CSU-Agricultural-Water-Quality-Program/awqp-loggers/figures/Cercospora-PT-joint-fig.jpg

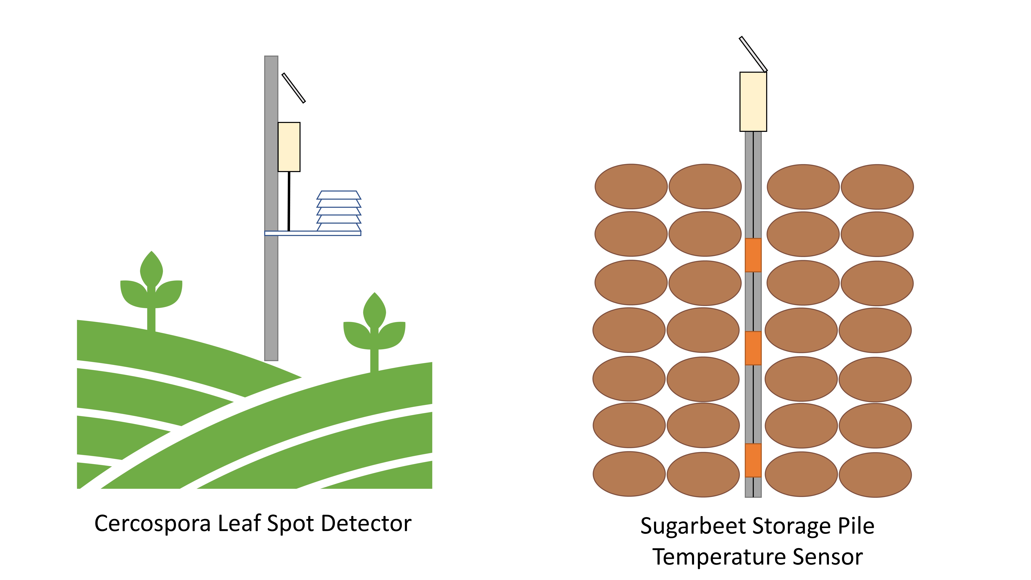
figures/Cercospora-PT-joint-fig.jpg
