CSU-Agricultural-Water-Quality-Program/awqp-loggers/figures/fig2.JPG

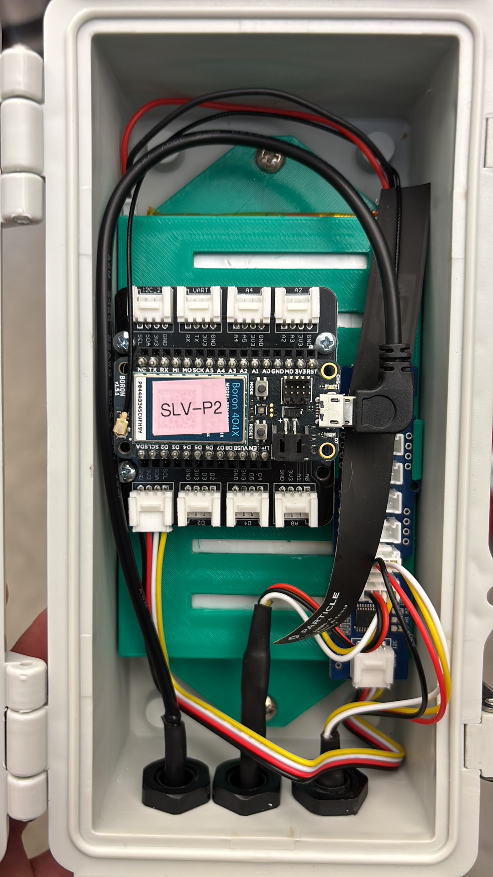
figures/fig2.JPG
