CSU-Agricultural-Water-Quality-Program/awqp-loggers/figures/Picture4.png

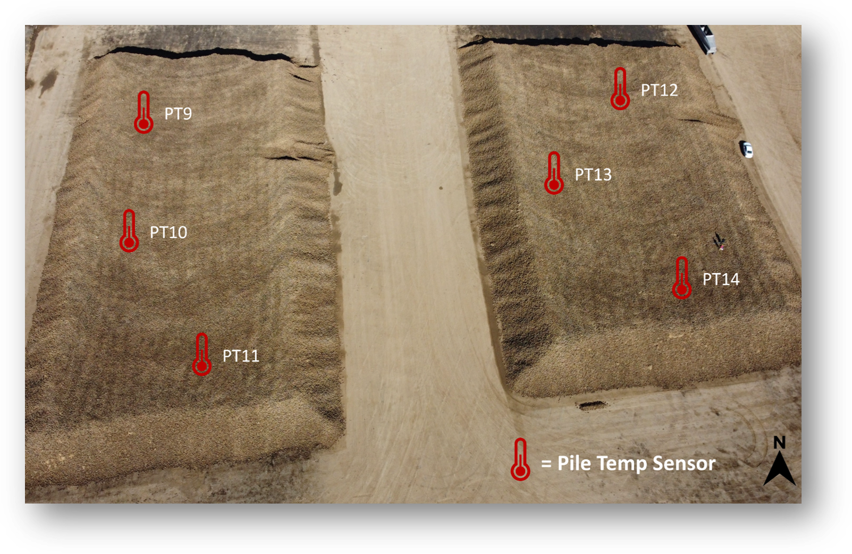
figures/Picture4.png
