CSU-Agricultural-Water-Quality-Program/awqp-loggers/instructional documents/2024 Cercospora Bill of Materials Powerpoint_9Feb2024.pdf

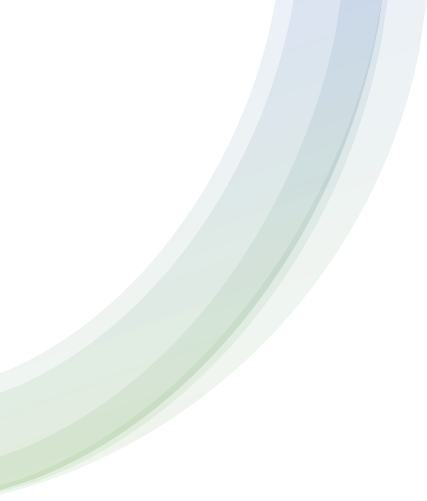
[picture p9: figure]
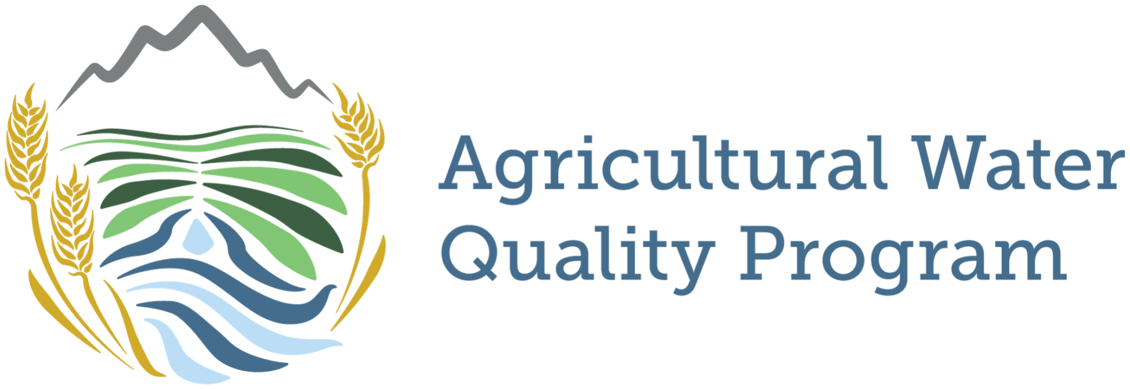
[picture p10: figure]
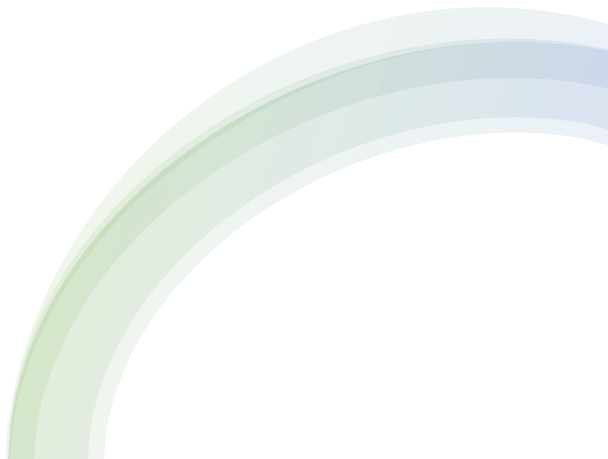
[picture p11: figure]

# Cercospora Bill of Materials

Created by the CSU Agricultural Water Quality Program

# Sensor Parts

SHT 31 Sensor Probe | Link: https://www.amazon.com/gp/p roduct/B09NYDCKF2/ref=ppx_y o_dt_b_search_asin_title?ie=U

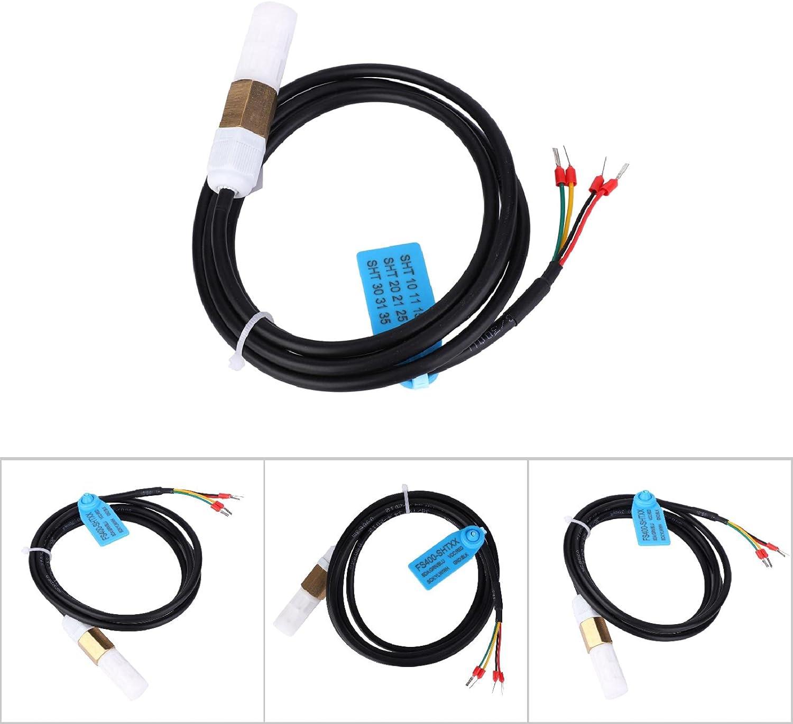
[picture p12: figure]

TF8&th=1 (https://www.amazon.com/gp/product/B09NYDCKF2/ref=ppx_yo_dt_b_search_asin_title?ie=UTF8&th=1)

Alternate if out of stock: Sht35: https://a.co/d/0hgxgrg

# Waterproof Polarized 4-Wire Cable Set

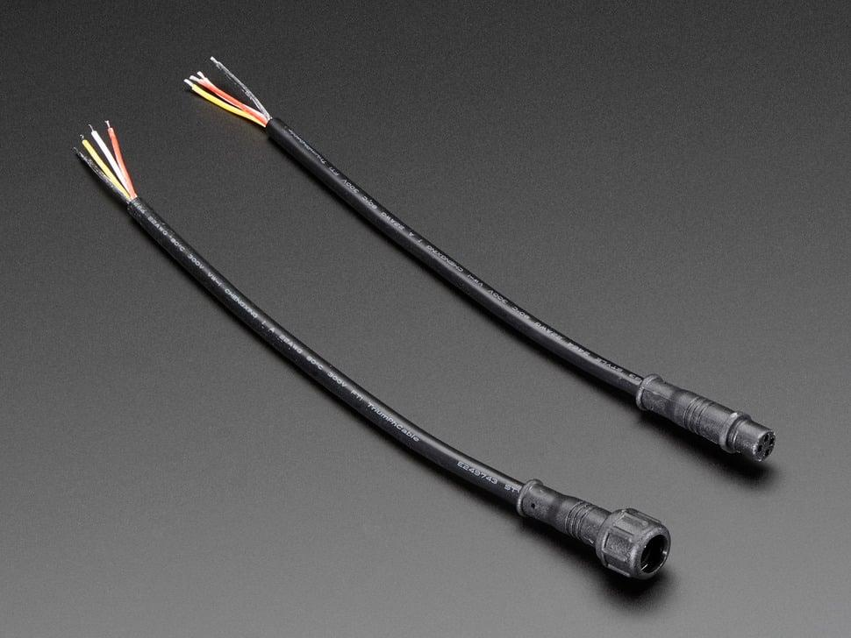
[picture p13: figure]

https://www.adafruit.com/product/744 (https://www.adafruit.com/product/744)

# Adafruit Micro Lipo - USB LiIon/LiPoly Charger

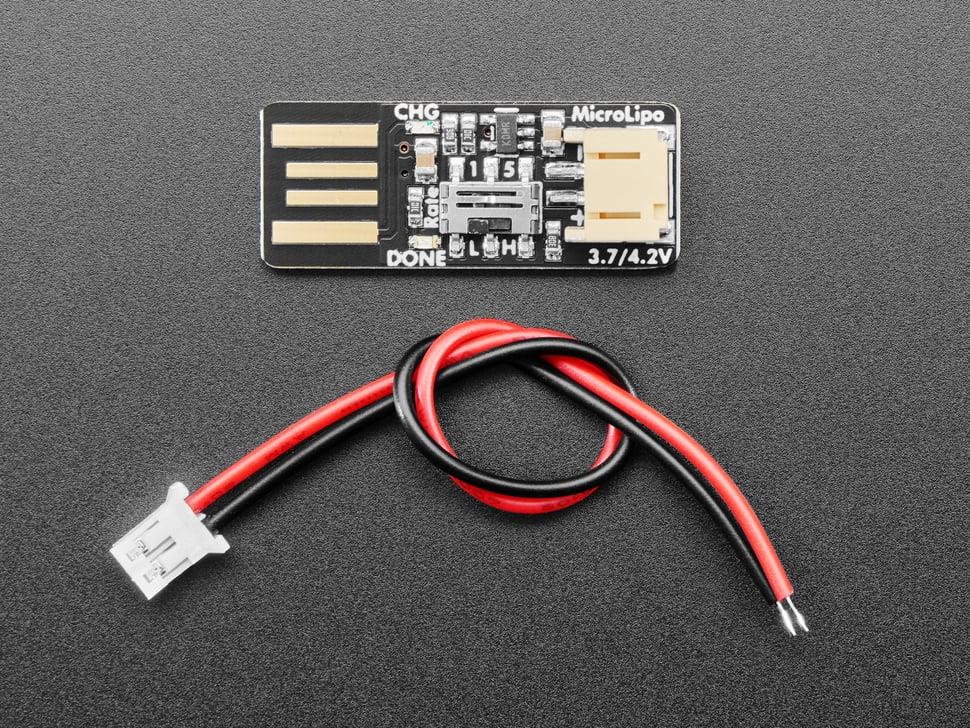
[picture p14: figure]

https://www.adafruit.com/product/1304 (https://www.adafruit.com/product/1304)

# Lithium Ion Battery Pack - 3.7V 4400mAh

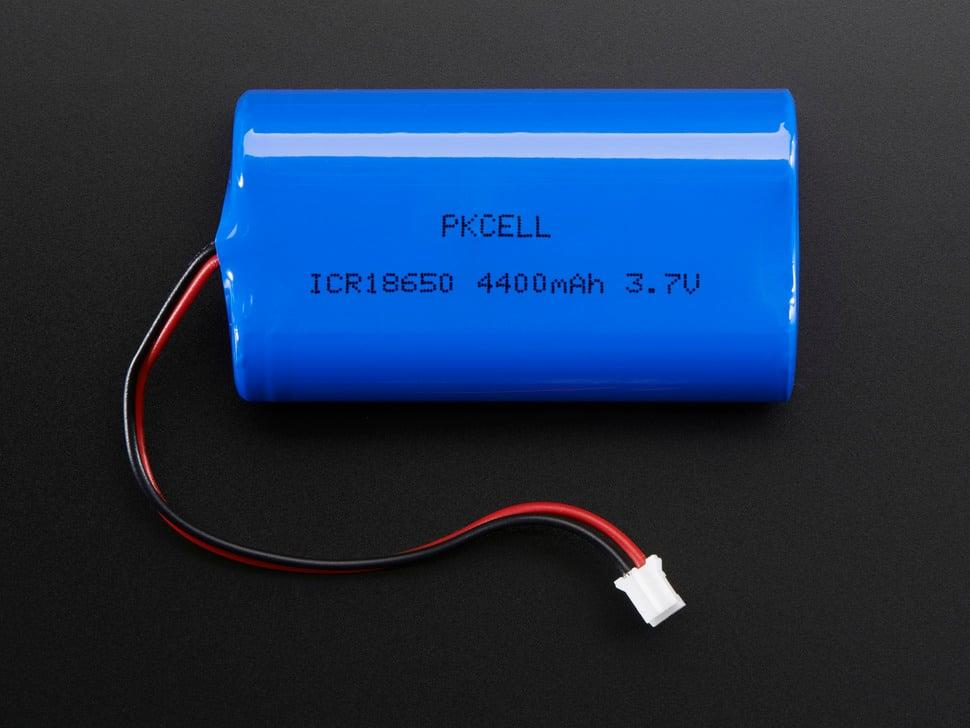
[picture p15: figure]

https://www.adafruit.com/product/354 (https://www.adafruit.com/product/354)

Alternate if out of stock: https://www.amazon.com/Battery-Packs-Lithium-Pack-3-
7V/dp/B0137IRGHG/ref=sr_1_1?crid =T7V5SLARPWZ3&keywords=Lithiu m+Ion+Battery+Pack+-
+3.7V+4400mAh&qid=1706741942 &sprefix=lithium+ion+battery+pack+ -
+3.7v+4400mah%2Caps%2C131&sr= 8-1 (https://www.amazon.com/Battery-Packs-Lithium-Pack-3-7V/dp/B0137IRGHG)

# Grove Shield FeatherWing

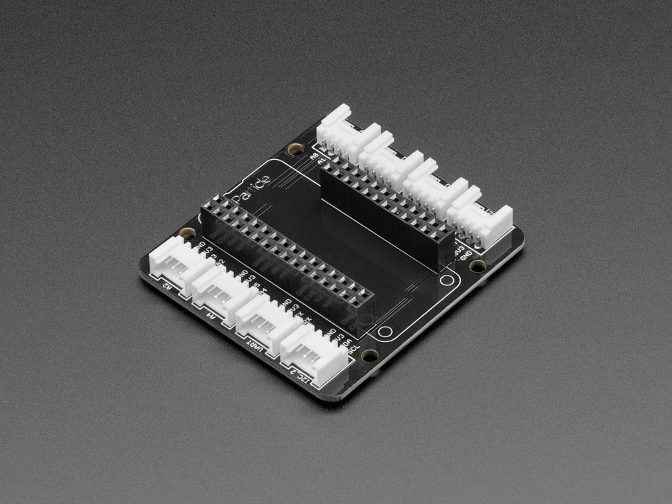
[picture p16: figure]

https://www.adafruit.com/product/4309 (https://www.adafruit.com/product/4309)

# Boron LTE CAT-M1 for North America (BRN404X)

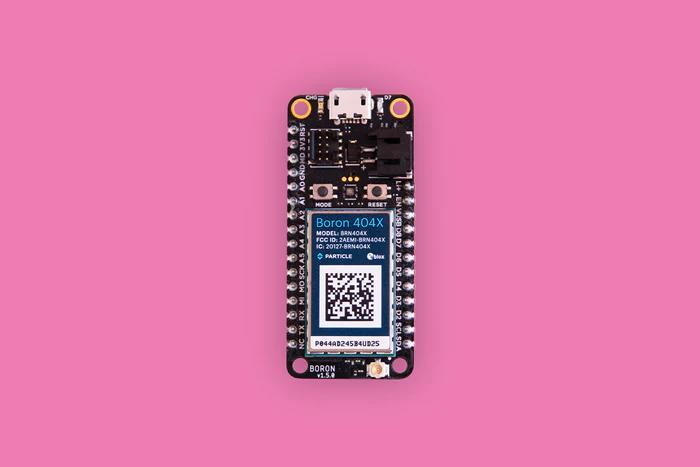
[picture p17: figure]

https://store.particle.io/collections/cellular/products/boron-lte-cat-m1-noram-with-ethersim-4th-gen

# Waterproof Enclosure (NEW)

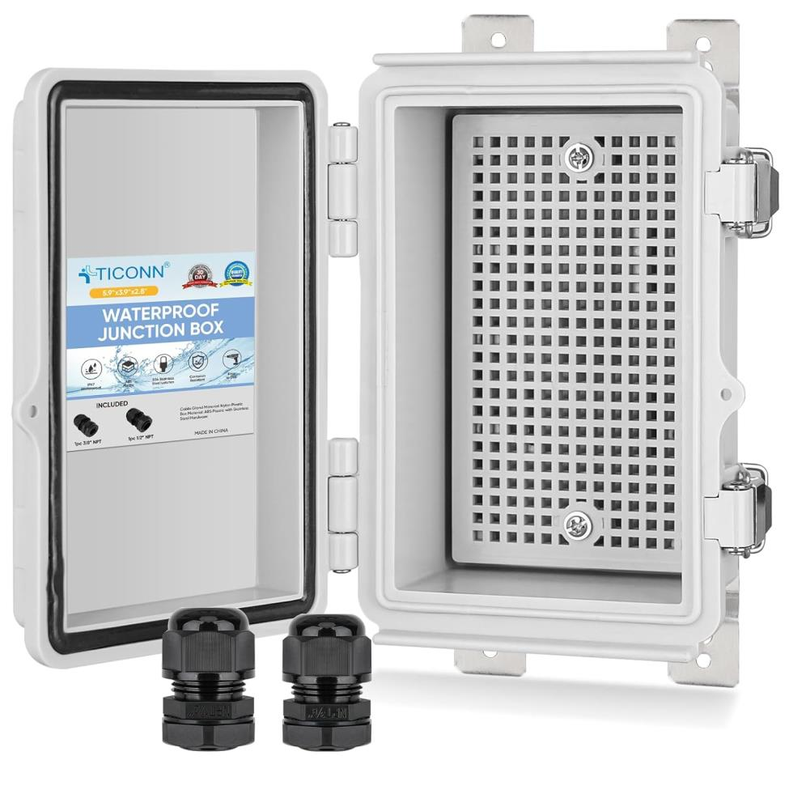
[picture p18: figure]

https://www.amazon.com/
dp/B0BZR3GZ4V/ref=twiste
r_B0B87THLGC?_encoding=
UTF8&psc=1 (https://www.amazon.com/dp/B0BZR3GZ4V/ref=twister_B0B87THLGC?_encoding=UTF8&psc=1)

# #6 x ½” Sheet Metal Screws

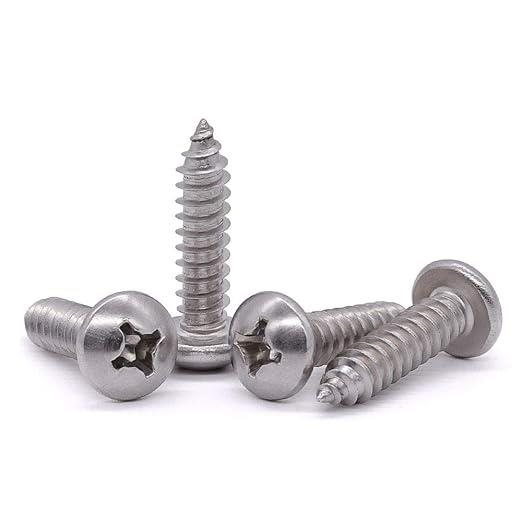
[picture p19: figure]

https://www.amazon.com/Stainless-Phillips-Tapping-Bright-Finish/dp/B08LV1M9FC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 (https://www.amazon.com/Stainless-Phillips-Tapping-Bright-Finish/dp/B08LV1M9FC)

# Silica Pack (30 pack)

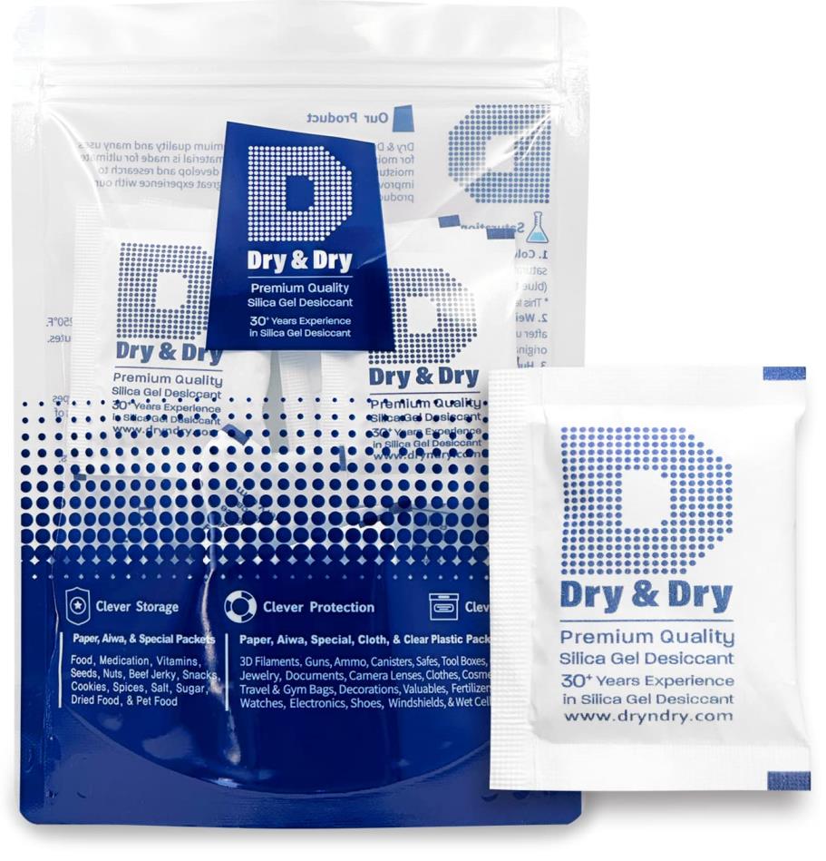
[picture p20: figure]

https://www.amazon.com/Dry-Premium-Packets-Desiccants-Dehumidifier/dp/B00VJ02VMK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 (https://www.amazon.com/Dry-Premium-Packets-Desiccants-Dehumidifier/dp/B00VJ02VMK)

# White Solder Seal Wire Connectors AWG26-24

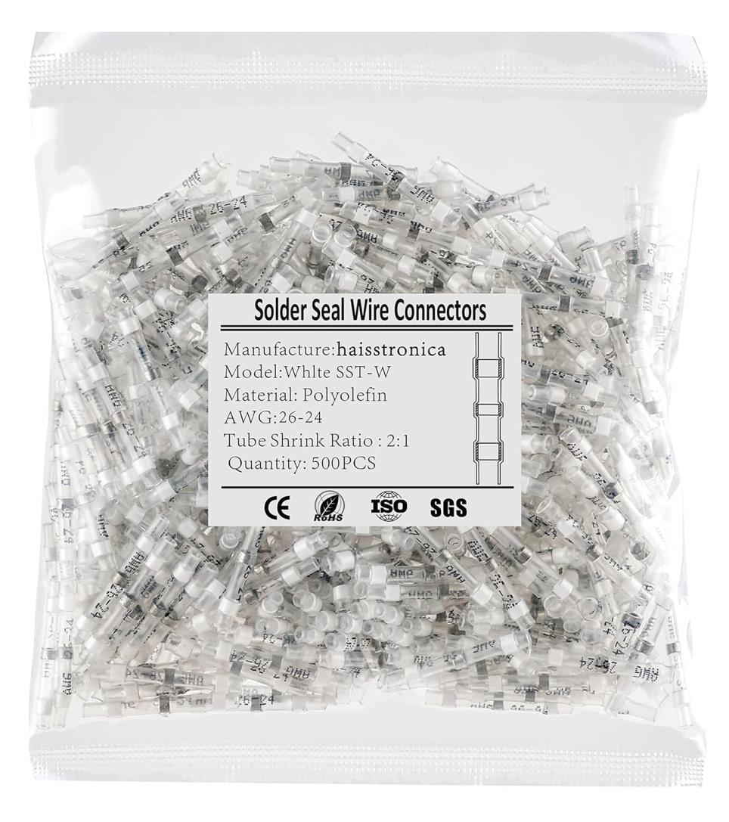
[picture p21: figure]

https://www.amazon.com/
gp/product/B09BHW6BWC
/ref=ppx_yo_dt_b_search_
asin_title?ie=UTF8&psc=1 (https://www.amazon.com/gp/product/B09BHW6BWC/ref=ppx_yo_dt_b_search_asin_title?ie=UTF8&psc=1)

# 1/4" Heat Shrink Tubing (50ft)

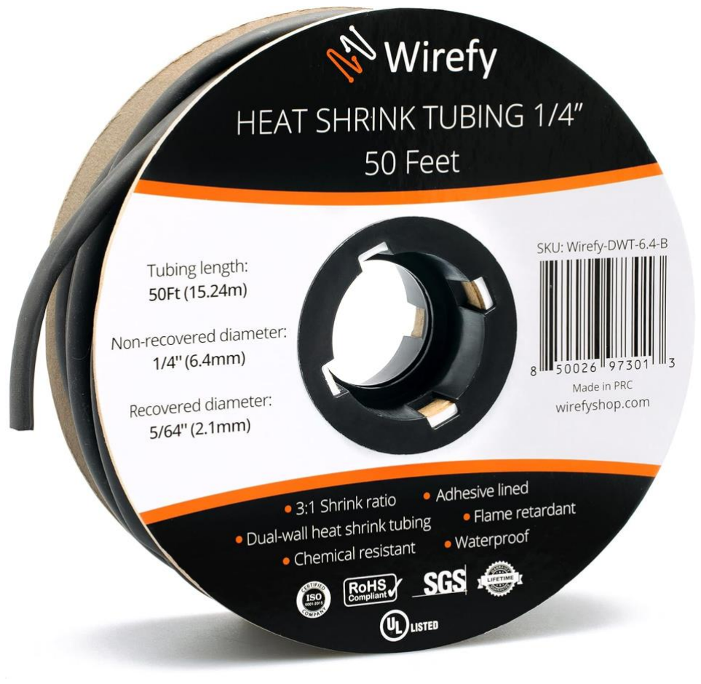
[picture p22: figure]

3:1 Ratio - Adhesive Lined - Marine Grade Heat Shrink - Black - 50 Feet Roll https://www.amazon.com/gp/product/B08W7RB32Z/ref=ppx_yo_dt_b_search_asin_title?ie=UTF8&th=1 (https://www.amazon.com/gp/product/B08W7RB32Z/ref=ppx_yo_dt_b_search_asin_title?ie=UTF8&th=1)

# Cable Gland (20 Pack) PG7 Waterproof

https://www.amazon.com/AMPELE-Waterproof-Plastic-Adjustable-3-5-
6mm/dp/B08TCFM4C7/ref=sxts_b2b_sx_reorder_ac b_customer?content-id=amzn1.sym.44ecadb3-1930-4ae5-8e7f-c0670e7d86ce%3Aamzn1.sym.44ecadb3-1930-4ae5-8e7fc0670e7d86ce&crid=1OH62VJ42NK1U&cv_ct_cx=pg 7%2Bcable%2Bgland&keywords=pg7%2Bcable%2Bgl and&pd_rd_i=B09X4GK3FT&pd_rd_r=d5becbf4-0c5a-42a5-abc4-
9cc85186de9b&pd_rd_w=O3qY1&pd_rd_wg=9baEq &pf_rd_p=44ecadb3-1930-4ae5-8e7fc0670e7d86ce&pf_rd_r=2YZKZZNZ8KDT9W166GAZ &qid=1702330671&sbo=RZvfv%2F%2FHxDF%2BO50 21pAnSA%3D%3D&sprefix=PG7%2B%2Caps%2C132 &sr=1-1-62d64017-76a9-4f2a-8002-d7ec97456eea&th=1

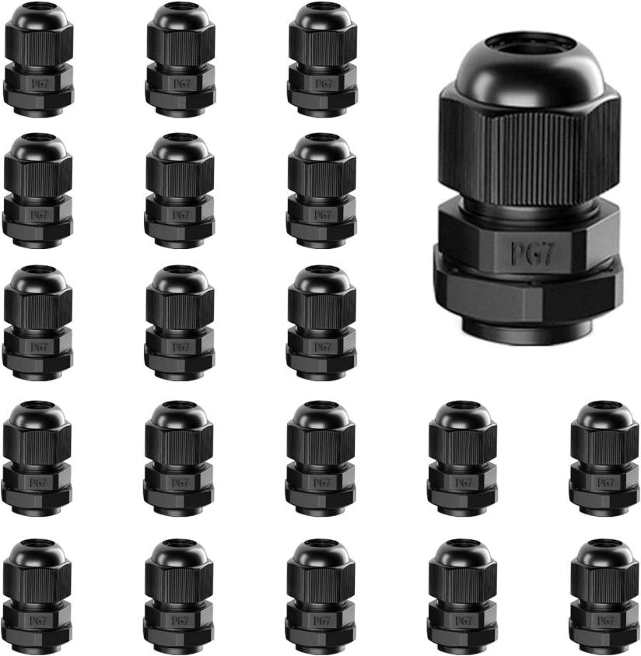
[picture p23: figure]

# 22 Gauge 4 Conductor Wire (65 ft)

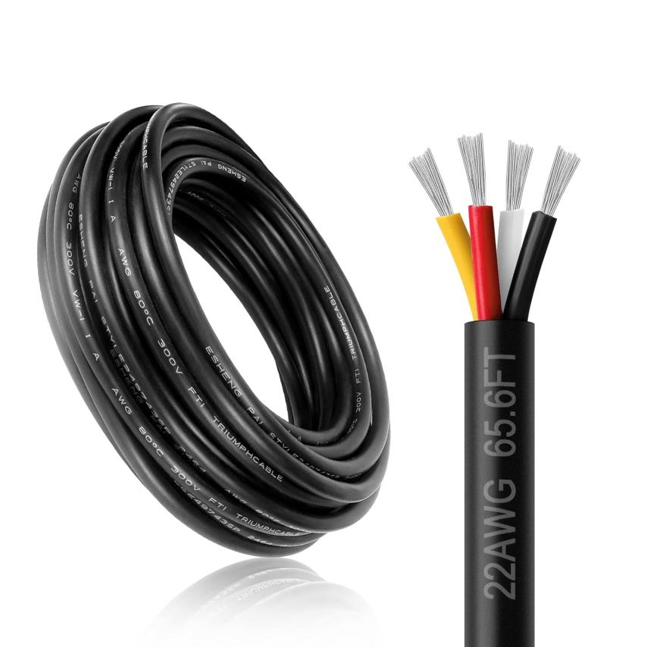
[picture p24: figure]

https://www.amazon.com/gp/product/B0BV2QHVMB/ref=ppx_yo_dt_b_search_asin_title?ie=UTF8&psc=1 (https://www.amazon.com/gp/product/B0BV2QHVMB/ref=ppx_yo_dt_b_search_asin_title?ie=UTF8&psc=1)

## SeeedStudio Grove - Universal 4 Pin Buckled 20cm Cable (5 PCs Pack)

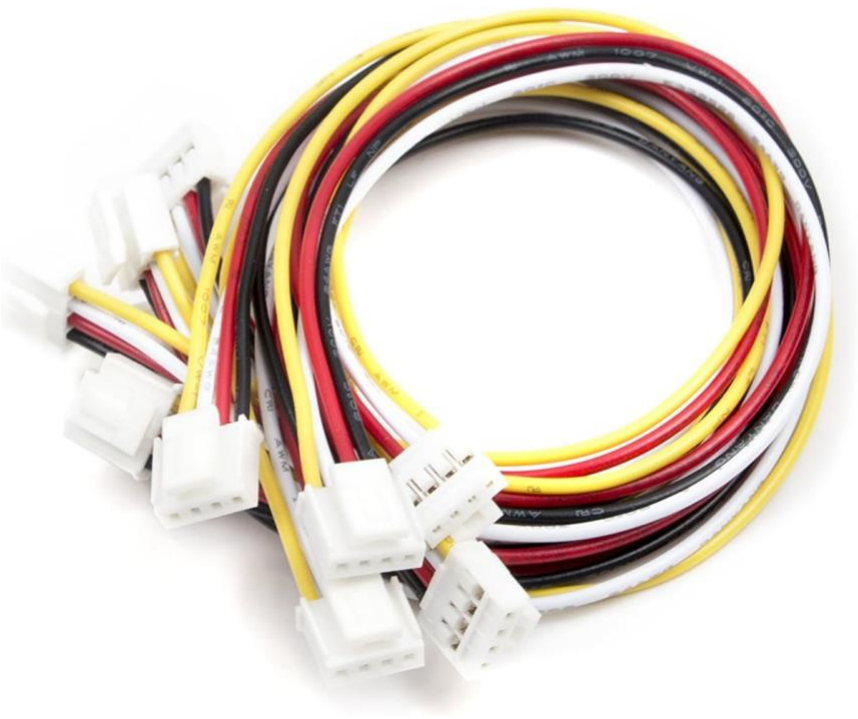
[picture p25: figure]

https://www.amazon.com/Seeedstudio-Grove-Universal-Buckled-Cable/dp/B01CNZ9RJO?th=1 (https://www.amazon.com/Seeedstudio-Grove-Universal-Buckled-Cable/dp/B01CNZ9RJO?th=1)

https://www.amazon.com/SeeedStudio-Grove-Universal-Buckled-Cable/dp/B07PWVY9YD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 (https://www.amazon.com/SeeedStudio-Grove-Universal-Buckled-Cable/dp/B07PWVY9YD?s=electronics)

# Fastening Cable Ties Reusable

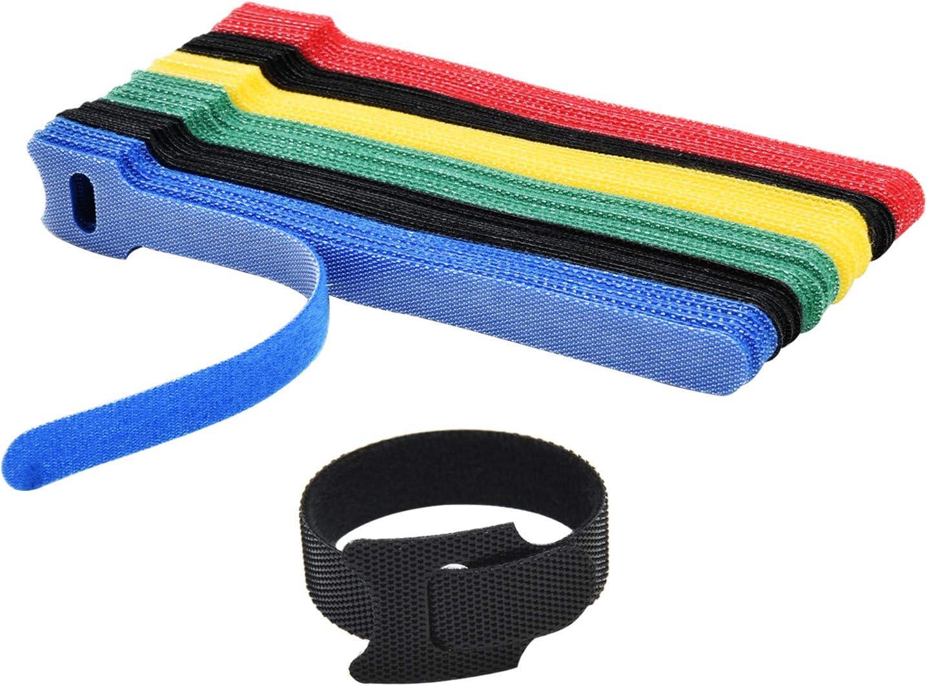
[picture p26: figure]

https://www.amazon.com/gp/product/B07V73G556/ref=ppx_yo_dt_b_search_asin_title?ie=UTF8&psc=1 (https://www.amazon.com/gp/product/B07V73G556/ref=ppx_yo_dt_b_search_asin_title?ie=UTF8&psc=1)

# 3/4 in. 1-Hole Strap

https://www.homedepot.com/p/Halex-Universal-3-4-in-1-Hole-Strap-4-Pack-22107/314968705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 3cuaG9tZWRlcG90LmNvbS9wL0hhbGV4LVVuaXZlcnNhbC0zLTQ taW4tMS1Ib2xlLVN0cmFwLTQtUGFjay0yMjEwNy8zMTQ5Njg3 MDUiCg&gclid=Cj0KCQiAh8OtBhCQARIsAIkWb6-ZNUGk4DF6_8K9b_SG3twg-
_4rTYJGDSozB688e1TayXbsJCpro0IaAm47EALw_wcB&gclsrc=aw .ds (https://www.homedepot.com/p/Halex-Universal-3-4-in-1-Hole-Strap-4-Pack-22107/314968705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)

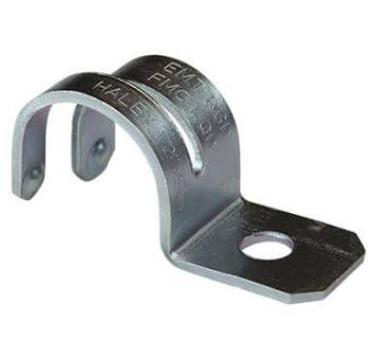
[picture p27: figure]

# Radiation Shield

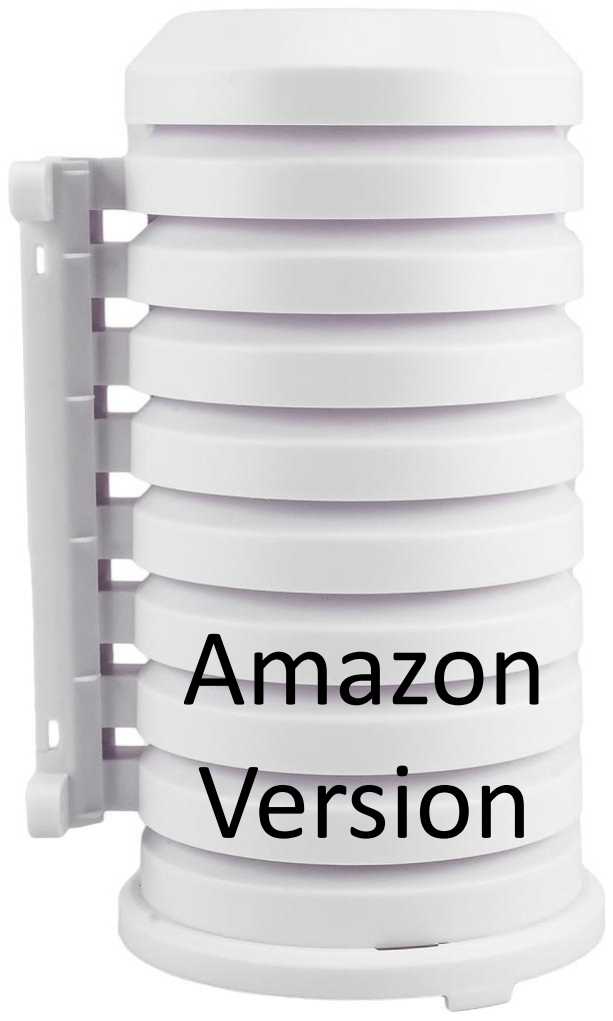
[picture p28: figure]
Amazon Version
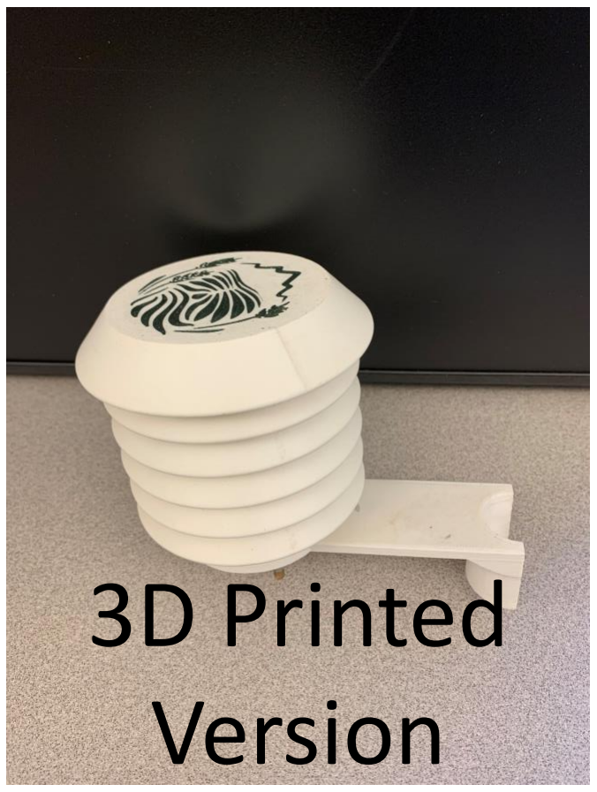
[picture p29: figure]
3D Printed Version

## - For 3D printed version:

## - contact Manny Deleon

## - For amazon version:

## - https://a.co/d/9YjHxkh

Disclaimer:
The instructions for sensor assembly only cover the use of the 3D-printed radiation shield, and using the amazon version may require some individual effort to figure out mounting for each deployment.

# Recommended Tools

# Cone Drill bit

## (note that ½" will also work, just make sure you use an appropriate bit for plastic)

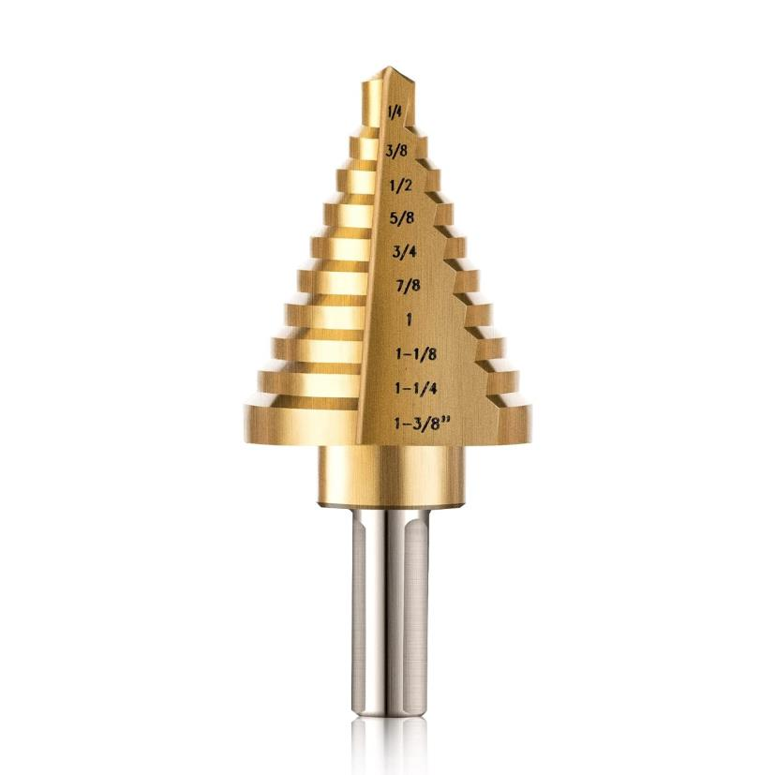
[picture p30: figure]

# Link: https://a.co/d/d9EyOLx

# Magnetic Soldering Alligator Clips

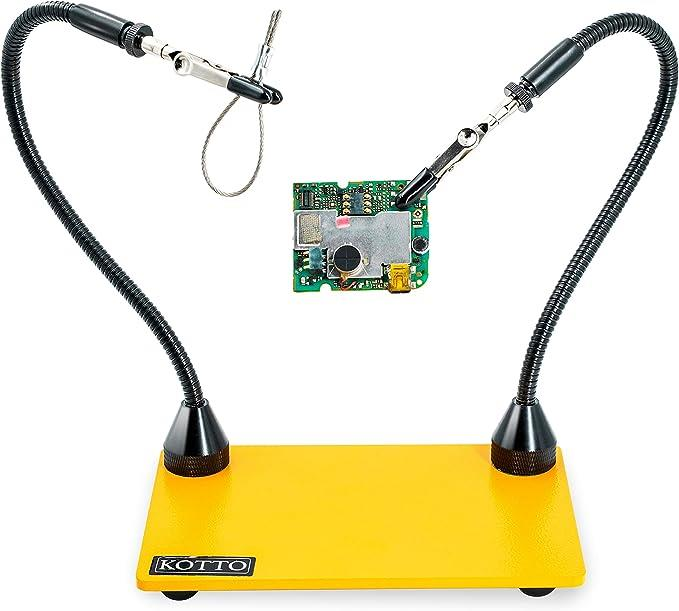
[picture p31: figure]

https://www.amazon.com/KOTTO-Soldering-Magnetic-Flexible-Workshop/dp/B083SFWLW7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 (https://www.amazon.com/KOTTO-Soldering-Magnetic-Flexible-Workshop/dp/B083SFWLW7)

# Wire Stripper

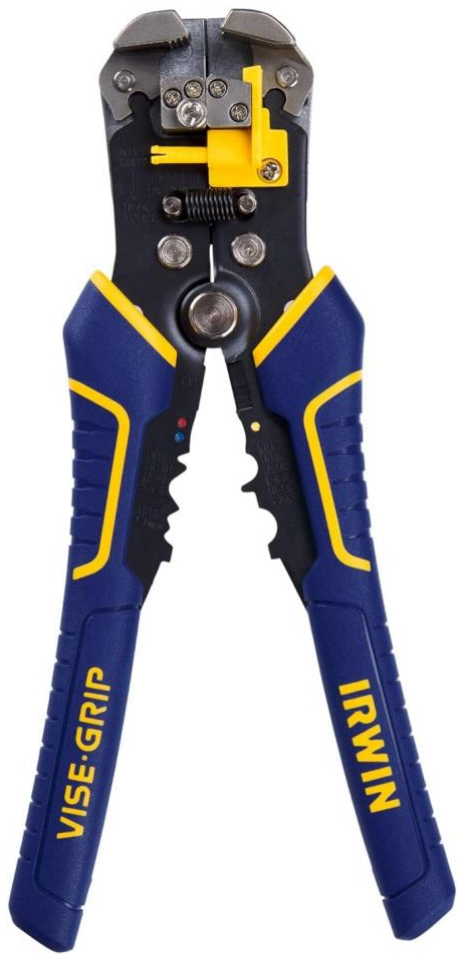
[picture p32: figure]

https://www.amazon.com/IRWIN-VISE-GRIP-2078300-Self-Adjusting-Stripper/dp/B000OQ21CA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 (https://www.amazon.com/IRWIN-VISE-GRIP-2078300-Self-Adjusting-Stripper/dp/B000OQ21CA)

# Mini Heat Gun

https://www.amazon.com/SEEKONE-Handheld-Reflector-Embossing-Stripping/dp/B08VFY8THD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 (https://www.amazon.com/SEEKONE-Handheld-Reflector-Embossing-Stripping/dp/B08VFY8THD)

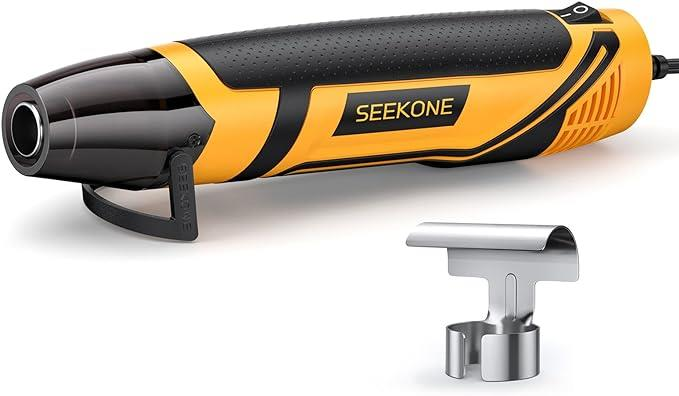
[picture p33: figure]

# Magnifying Glass w/ Light

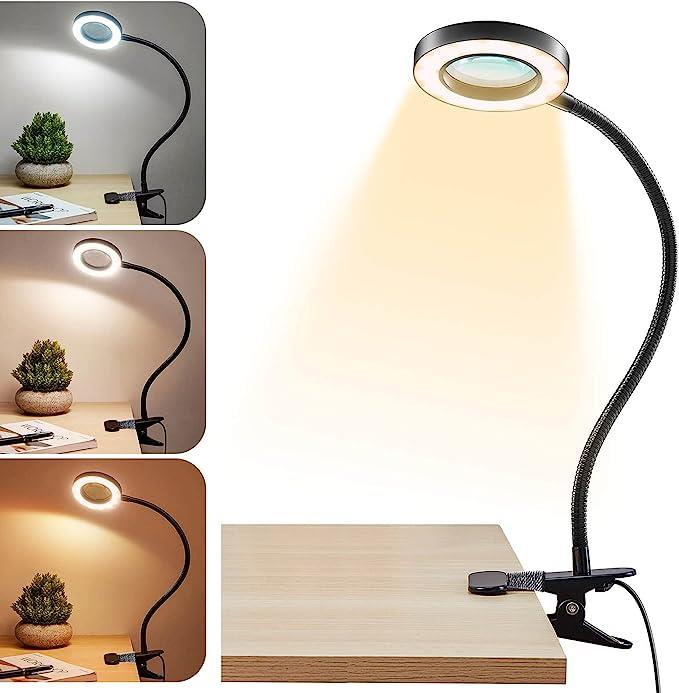
[picture p34: figure]

https://www.amazon.com/Magnifying-Reading-Dimmable-Eye-Caring-Headboard/dp/B09M9YYSGB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 (https://www.amazon.com/Magnifying-Reading-Dimmable-Eye-Caring-Headboard/dp/B09M9YYSGB)
