CSU-Agricultural-Water-Quality-Program/awqp-loggers/instructional documents/Cercospora Bill of Material.xlsx

Sheet: 2023
Main Items
Item Name | Price | qty | Link
SHT 31 Sensor Probe | $18.99 | 1 | https://www.amazon.com/gp/product/B09NYDCKF2/ref=ppx_yo_dt_b_search_asin_title?ie=UTF8&th=1
Waterproof Polarized 4-Wire Cable Set | $2.50 | 1 | https://www.adafruit.com/product/744
Adafruit Micro Lipo - USB LiIon/LiPoly Charger | $5.95 | 1 | https://www.adafruit.com/product/1304
Lithium Ion Battery Pack - 3.7V 4400mAh | $19.95 | 2 | https://www.adafruit.com/product/354
Grove Shield FeatherWing for Particle Mesh and all Feathers | $5.95 | 1 | https://www.adafruit.com/product/4309
6V 2W Solar Panel - ETFE - Voltaic P126 | $20.95 | 1 | https://www.adafruit.com/product/5366
3D Mount for the Grove Shield FeatherWing for Particle with LiPo |  | 1 | https://www.printables.com/model/677827-mount-for-the-grove-shield-featherwing-for-particl
Boron LTE CAT-M1 for North America (BRN404X) | $65.00 | 1 | https://store.particle.io/collections/cellular/products/boron-lte-cat-m1-noram-with-ethersim-4th-gen
Waterproof Enclosure (Old) | $9.99 | 1 | https://www.amazon.com/dp/B0787B1GT3/ref=redir_mobile_desktop?_encoding=UTF8&ref_=yo_ii_img&th=1
Waterproof Enclosure (NEW) | $19.99 | 1 | https://www.amazon.com/dp/B0BZR3GZ4V/ref=twister_B0B87THLGC?_encoding=UTF8&psc=1
3/4" Push Install Type EMT T Conduit Body | $14.99 | 1 | https://www.amazon.com/Southwire-TB-075-Push-Install-Conduit/dp/B07RWPTQP2?s=hi
Packs of Items
Silica Pack (30 pack) | $9.99 | 1 | https://www.amazon.com/Dry-Premium-Packets-Desiccants-Dehumidifier/dp/B00VJ02VMK
White Solder Seal Wire Connectors AWG26-24 | $33.99 | 1 | https://www.amazon.com/gp/product/B09BHW6BWC/ref=ppx_yo_dt_b_search_asin_title?ie=UTF8&psc=1
3/16" Heat Shrink Tubing (50ft) | $21.55 | 1 | https://www.amazon.com/gp/product/B08WB2HR66/ref=ppx_yo_dt_b_search_asin_title?ie=UTF8&th=1
22 Gauge 4 Conductor Wire (65 ft) | $27.88 | 1 | https://www.amazon.com/gp/product/B0BV2QHVMB/ref=ppx_yo_dt_b_search_asin_title?ie=UTF8&psc=1
Cable Gland (20 Pack) PG7 Waterproof | $7.99 | 1 | https://www.amazon.com/AMPELE-Waterproof-Plastic-Adjustable-3-5-6mm/dp/B08TCFM4C7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
3/4 in. Electrical Metallic Tube Raintight Compression Connectors (20-Pack) | $25.27 | 1 | https://www.homedepot.com/p/Halex-3-4-in-Electrical-Metallic-Tube-Raintight-Compression-Connectors-20-Pack-62502B/300183944
Petg filaments | $20.00 | 1 | https://www.amazon.com/OVERTURE-Filament-Consumables-Dimensional-Accuracy/dp/B07PDV9RC8
SeeedStudio Grove - Universal 4 Pin Buckled 20cm Cable (5 PCs Pack) | $8.59 | 1 | https://www.amazon.com/Seeedstudio-Grove-Universal-Buckled-Cable/dp/B01CNZ9RJO?th=1

Sheet: 2024
2024
Main Items
Item Name | Price | unit | $/unit | qty | Total/sensor | Link
SHT 31 Sensor Probe | $18.99 | each | $18.99 | 1 | $18.99 | https://www.amazon.com/gp/product/B09NYDCKF2/ref=ppx_yo_dt_b_search_asin_title?ie=UTF8&th=1
Waterproof Polarized 4-Wire Cable Set | $2.50 | each | $2.50 | 1 | $2.50 | https://www.adafruit.com/product/744
Adafruit Micro Lipo - USB LiIon/LiPoly Charger | $5.95 | each | $5.95 | 1 | $5.95 | https://www.adafruit.com/product/1304
Lithium Ion Battery Pack - 3.7V 4400mAh | $19.95 | each | $19.95 | 2 | $39.90 | https://www.adafruit.com/product/354
Grove Shield FeatherWing for Particle Mesh and all Feathers | $5.95 | each | $5.95 | 1 | $5.95 | https://www.adafruit.com/product/4309
Boron LTE CAT-M1 for North America (BRN404X) | $65.00 | each | $65.00 | 1 | $65.00 | https://store.particle.io/collections/cellular/products/boron-lte-cat-m1-noram-with-ethersim-4th-gen
Waterproof Enclosure (NEW) | $19.99 | each | $19.99 | 1 | $19.99 | https://www.amazon.com/dp/B0BZR3GZ4V/ref=twister_B0B87THLGC?_encoding=UTF8&psc=1
Radiation Shield (Amazon Version) | $22.10 | each | $22.10 | 1 | $22.10 | https://a.co/d/9YjHxkh
Packs of Items (You have to buy at least one pack)
#6 x ½” Sheet Metal Screws | $7.99 | 100 pk | $0.08 | 1 | $0.08 | https://www.amazon.com/Stainless-Phillips-Tapping-Bright-Finish/dp/B08LV1M9FC
Silica Pack (30 pack) | $9.99 | 30 pk | $0.33 | 1 | $0.33 | https://www.amazon.com/Dry-Premium-Packets-Desiccants-Dehumidifier/dp/B00VJ02VMK
White Solder Seal Wire Connectors AWG26-24 | $33.99 | 500 pk | $0.07 | 4 | $0.27 | https://www.amazon.com/gp/product/B09BHW6BWC/ref=ppx_yo_dt_b_search_asin_title?ie=UTF8&psc=1
1/4" Heat Shrink Tubing (50ft) | $21.55 | 50 ft | $0.43 | 1 | $0.43 | https://www.amazon.com/gp/product/B08WB2HR66/ref=ppx_yo_dt_b_search_asin_title?ie=UTF8&th=1
22 Gauge 4 Conductor Wire (65 ft) | $27.88 | 65 ft | $0.43 | 7 | $3.00 | https://www.amazon.com/gp/product/B0BV2QHVMB/ref=ppx_yo_dt_b_search_asin_title?ie=UTF8&psc=1
Cable Gland (20 Pack) PG7 Waterproof | $7.99 | 20 pk | $0.40 | 1 | $0.40 | https://www.amazon.com/AMPELE-Waterproof-Plastic-Adjustable-3-5-6mm/dp/B08TCFM4C7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
SeeedStudio Grove - Universal 4 Pin Buckled 20cm Cable (5 PCs Pack) | $8.59 | 5 pk | $1.72 | 1 | $1.72 | https://www.amazon.com/Seeedstudio-Grove-Universal-Buckled-Cable/dp/B01CNZ9RJO?th=1
Fastening Cable Ties Reusable | $5.99 | 60 pk | $0.10 | 1 | $0.10 | https://www.amazon.com/gp/product/B07V73G556/ref=ppx_yo_dt_b_search_asin_title?ie=UTF8&psc=1
3/4 in. 1-Hole Strap | $2.50 | 4 pk | $0.62 | 2 | $1.25 | https://www.homedepot.com/p/Halex-Universal-3-4-in-1-Hole-Strap-4-Pack-22107/314968705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
Total | $286.90 |  |  |  | $187.97
 | ^total including cost to buy bulk items |  |  |  | ^total when accounting for using the exact number of parts
Recommended Tools
Cone Drill Bit | $10.99 |  |  | 1 |  | https://a.co/d/d9EyOLx
Magnetic Soldering Alligator Clips | $21.99 |  |  | 1 |  | https://www.amazon.com/KOTTO-Soldering-Magnetic-Flexible-Workshop/dp/B083SFWLW7
Wire Stripper | $25.99 |  |  | 1 |  | https://www.amazon.com/IRWIN-VISE-GRIP-2078300-Self-Adjusting-Stripper/dp/B000OQ21CA
Mini Heat Gun | $24.99 |  |  | 1 |  | https://www.amazon.com/SEEKONE-Handheld-Reflector-Embossing-Stripping/dp/B08VFY8THD
Magnifying Glass w/ Light | $19.99 |  |  | 1 |  | https://www.amazon.com/Magnifying-Reading-Dimmable-Eye-Caring-Headboard/dp/B09M9YYSGB
Total | $103.95
Please Email AJ Brown or Emmanuel Deleon for questions or substitutes when parts are out of stock:
Ansley.Brown@colostate.edu
E.Deleon@colostate.edu
