CSU-Agricultural-Water-Quality-Program/awqp-loggers/(commit log)

2022-05-04 Update xintemphumsht31.ino
    Updated to make readings occur every 30 min. and to include sleep function on boron to save battery.
2024-02-05 init sensor revamp
    new parts list, new firmware, only one sensor type moving forward (SHT31)
    [Cercospora Bill of Material.xlsx]
2024-02-13 updated parts list and contents
    [Cercospora Bill of Material.xlsx]
